Ethancao123/shark-bite/hardware/shark-bite/malenki-hv.kicad_pcb

## KiCad design hardware/shark-bite/malenki-hv.kicad_pcb (2024-10-05)

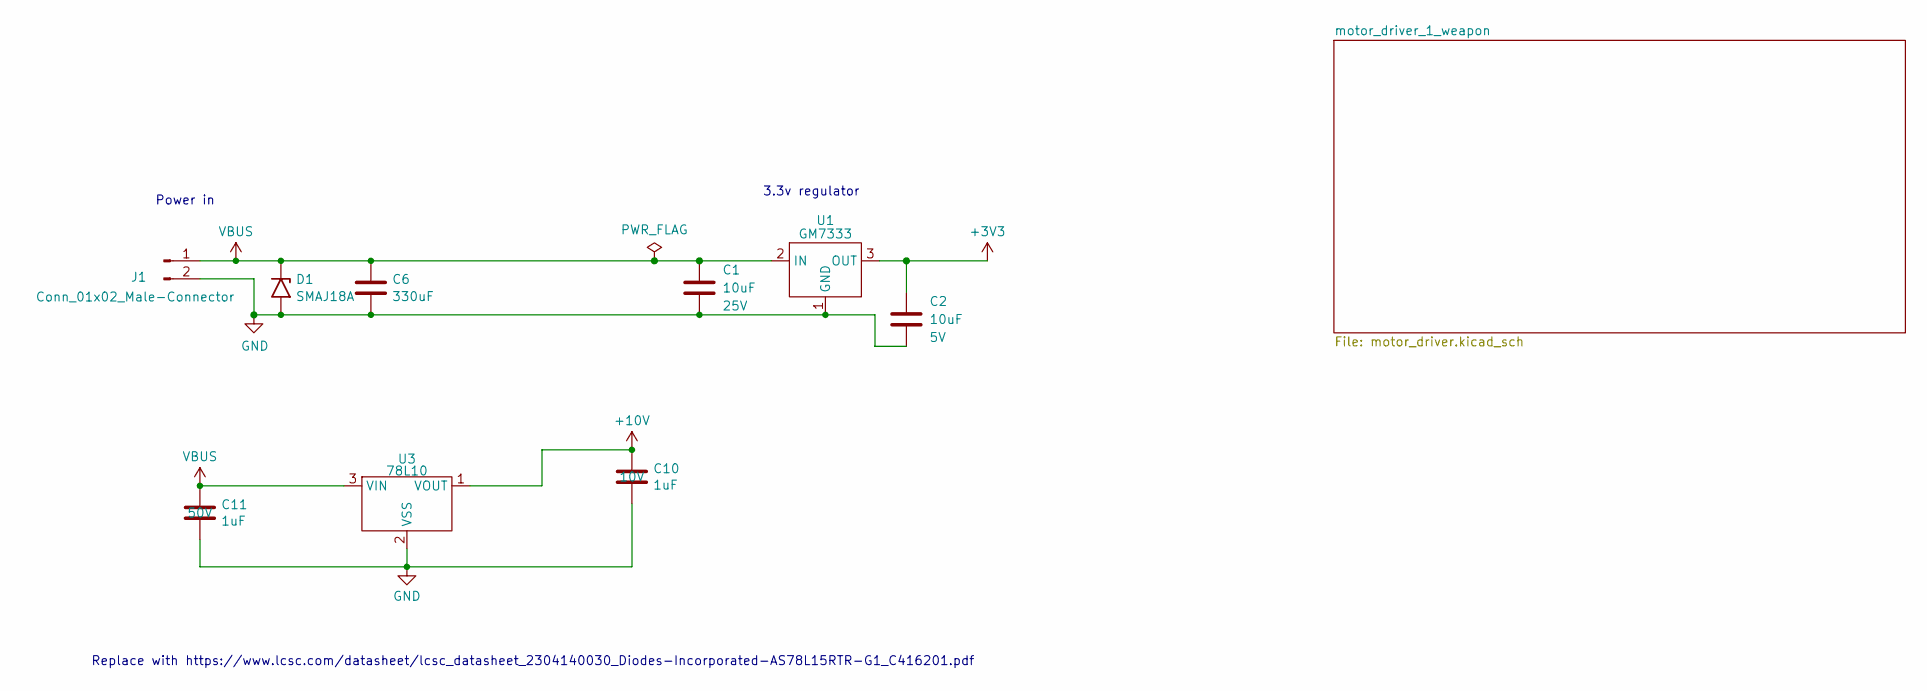
[picture p1: schematic malenki-hv.kicad_sch]

Parts:
C1, C2: 10uF; C_0603_1608Metric
C6: 330uF; C_0603_1608Metric
C10, C11: 1uF; C_0603_1608Metric
D1: SMAJ18A; D_SMA; LCSC C20883287
J1: Conn_01x02_Male-Connector; Power Input
U1: GM7333; SOT-89-3; LCSC C2833582
U3: 78L10; SOT-89-3; LCSC C6718417

Connections:
+3V3: C2.1, U1.3 (OUT); also elsewhere on the board
+10V: C10.1, U3.1 (VOUT); also elsewhere on the board
GND: C1.2, C2.2, C6.2, C10.2, C11.2, D1.2 (A2), J1.2, U1.1 (GND), U3.2 (VSS); also elsewhere on the board
VBUS: C1.1, C6.1, C11.1, D1.1 (A1), J1.1, U1.2 (IN), U3.3 (VIN); also elsewhere on the board

Notes on the sheet:
Power in
3.3v regulator
Replace with https://www.lcsc.com/datasheet/lcsc_datasheet_2304140030_Diodes-Incorporated-AS78L15RTR-G1_C416201.pdf

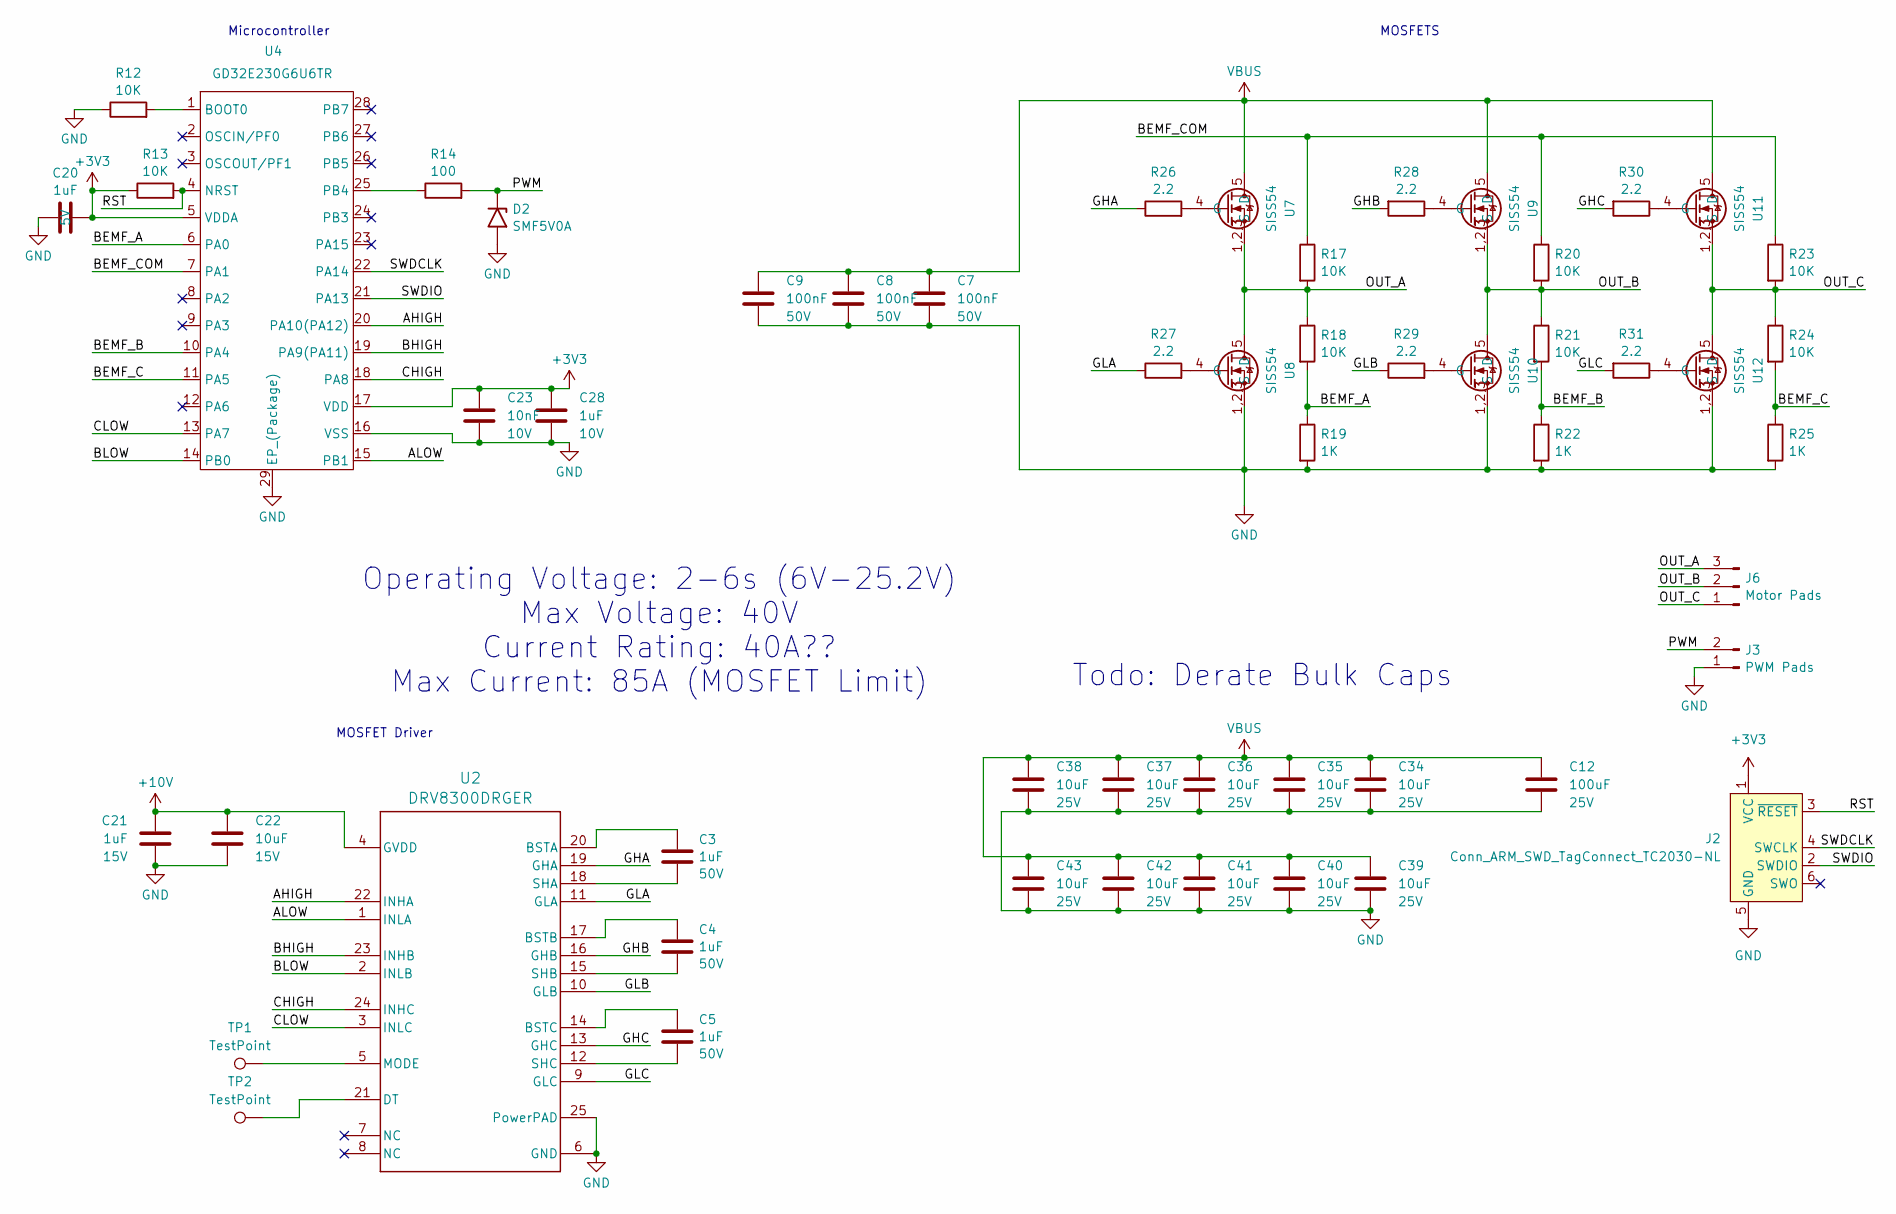
[picture p2: schematic motor_driver.kicad_sch]

Parts:
C3, C4, C5: 1uF; C_0603_1608Metric; LCSC C307331
C7, C8, C9: 100nF; C_0402_1005Metric; LCSC C307331
C12: 100uF; LCSC C556232
C20, C21, C28: 1uF; C_0402_1005Metric_Pad0.74x0.62mm_HandSolder
C22: 10uF; C_0402_1005Metric_Pad0.74x0.62mm_HandSolder
C23: 10nF; C_0402_1005Metric_Pad0.74x0.62mm_HandSolder
C34, C35, C36, C37, C38, C39, C40, C41, C42, C43: 10uF; C_0603_1608Metric
D2: SMF5V0A; D_SMF; LCSC C1972946
J2: Conn_ARM_SWD_TagConnect_TC2030-NL; Tag-Connect_TC2030-IDC-NL_2x03_P1.27mm_Vertical
J3: PWM Pads; PinHeader_1x02_P1.00mm_Vertical
J6: Motor Pads; ESC Pads
R12, R13, R17, R18, R20, R21, R23, R24: 10K; R_0402_1005Metric; LCSC C25744
R14: 100; R_0402_1005Metric
R19, R22, R25: 1K; R_0402_1005Metric; LCSC C11702
R26, R27, R28, R29, R30, R31: 2.2; R_0603_1608Metric
TP1, TP2: TestPoint; TestPoint_Pad_1.0x1.0mm
U2: DRV8300DRGER; RGE0024B-IPC_A
U4: GD32E230G6U6TR; QFN-28-1EP_4x4mm_P0.4mm_EP2.6x2.6mm; LCSC C2835081
U7, U8, U9, U10, U11, U12: SISS54; 1212-8S; LCSC C67862

Connections:
+3V3: C20.1, C23.2, C28.2, J2.1 (VCC), R13.1, U4.5 (VDDA), U4.17 (VDD); also elsewhere on the board
+10V: C21.2, C22.2, U2.4 (GVDD); also elsewhere on the board
/motor_driver_1_weapon/AHIGH: U2.22 (INHA), U4.20 (PA10(PA12))
/motor_driver_1_weapon/ALOW: U2.1 (INLA), U4.15 (PB1)
/motor_driver_1_weapon/BEMF_A: R18.2, R19.1, U4.6 (PA0)
/motor_driver_1_weapon/BEMF_B: R21.2, R22.1, U4.10 (PA4)
/motor_driver_1_weapon/BEMF_C: R24.2, R25.1, U4.11 (PA5)
/motor_driver_1_weapon/BEMF_COM: R17.1, R20.1, R23.1, U4.7 (PA1)
/motor_driver_1_weapon/BHIGH: U2.23 (INHB), U4.19 (PA9(PA11))
/motor_driver_1_weapon/BLOW: U2.2 (INLB), U4.14 (PB0)
/motor_driver_1_weapon/CHIGH: U2.24 (INHC), U4.18 (PA8)
/motor_driver_1_weapon/CLOW: U2.3 (INLC), U4.13 (PA7)
/motor_driver_1_weapon/GHA: R26.1, U2.19 (GHA)
/motor_driver_1_weapon/GHB: R28.2, U2.16 (GHB)
/motor_driver_1_weapon/GHC: R30.2, U2.13 (GHC)
/motor_driver_1_weapon/GLA: R27.1, U2.11 (GLA)
/motor_driver_1_weapon/GLB: R29.1, U2.10 (GLB)
/motor_driver_1_weapon/GLC: R31.2, U2.9 (GLC)
/motor_driver_1_weapon/OUT_A: J6.3, R17.2, R18.1, U7.1,2,3 (S), U8.5 (D)
/motor_driver_1_weapon/OUT_B: J6.2, R20.2, R21.1, U9.1,2,3 (S), U10.5 (D)
/motor_driver_1_weapon/OUT_C: J6.1, R23.2, R24.1, U11.1,2,3 (S), U12.5 (D)
/motor_driver_1_weapon/PWM: D2.1 (A1), J3.2, R14.2
/motor_driver_1_weapon/RST: J2.3 (~RESET), R13.2, U4.4 (NRST)
/motor_driver_1_weapon/SWDCLK: J2.4 (SWCLK), U4.22 (PA14)
/motor_driver_1_weapon/SWDIO: J2.2 (SWDIO), U4.21 (PA13)
GND: C7.2, C8.2, C9.2, C12.2, C20.2, C21.1, C22.1, C23.1, C28.1, C34.2, C35.2, C36.2, C37.2, C38.2, C39.2, C40.2, C41.2, C42.2, C43.2, D2.2 (A2), J2.5 (GND), J3.1, R12.1, R19.2, R22.2, R25.2, U2.6 (GND), U2.25 (PowerPAD), U4.16 (VSS), U4.29 (EP_(Package)), U8.1,2,3 (S), U10.1,2,3 (S), U12.1,2,3 (S); also elsewhere on the board
unnamed: C3.1, U2.20 (BSTA)
unnamed: C4.1, U2.17 (BSTB)
unnamed: C5.1, U2.14 (BSTC)
unnamed: TP2.1, U2.21 (DT)
unnamed: TP1.1, U2.5 (MODE)
unnamed: C3.2, U2.18 (SHA)
unnamed: C4.2, U2.15 (SHB)
unnamed: C5.2, U2.12 (SHC)
unnamed: R12.2, U4.1 (BOOT0)
unnamed: R14.1, U4.25 (PB4)
unnamed: R26.2, U7.4 (G)
unnamed: R27.2, U8.4 (G)
unnamed: R28.1, U9.4 (G)
unnamed: R29.2, U10.4 (G)
unnamed: R30.1, U11.4 (G)
unnamed: R31.1, U12.4 (G)
VBUS: C7.1, C8.1, C9.1, C12.1, C34.1, C35.1, C36.1, C37.1, C38.1, C39.1, C40.1, C41.1, C42.1, C43.1, U7.5 (D), U9.5 (D), U11.5 (D); also elsewhere on the board

Notes on the sheet:
Todo: Derate Bulk Caps
Operating Voltage: 2-6s (6V-25.2V) Max Voltage: 40V Current Rating: 40A?? Max Current: 85A (MOSFET Limit)
MOSFET Driver
MOSFETS
Microcontroller

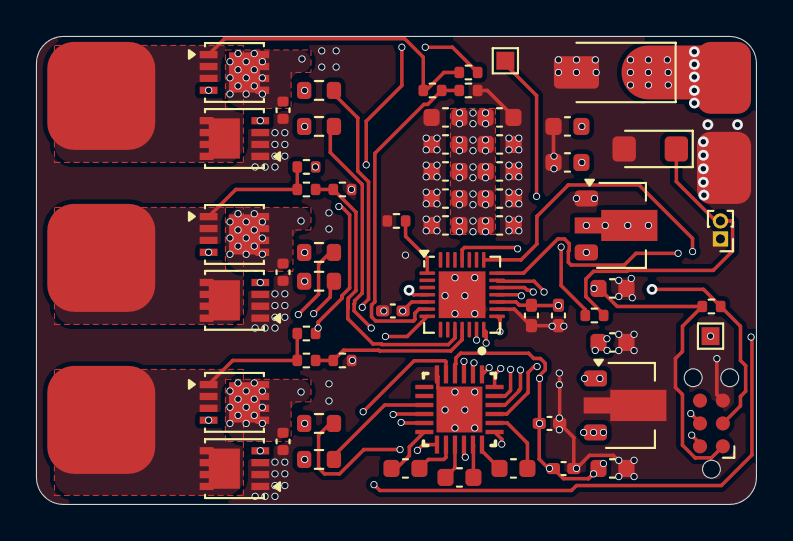
[picture p3: board malenki-hv.kicad_pcb from above]

Board: 4 copper layers, 40.0 x 26.0 mm, 62 parts (0 on the bottom side), 43 nets.
