Ethancao123/shark-bite/(commit log)

2024-04-22 Created ESC Microcontroller and MOSFET Driver
    [drv8837_breakout.kicad_pcb, drv8837_breakout.sch, malenki-1616.kicad_pcb, malenki-1616.kicad_sch, malenki-holder.FCStd, malenki-hv-bom.csv, malenki-hv.kicad_pcb, malenki-hv.kicad_sch]
2024-04-22 Added TVS Diodes
    [malenki-hv.kicad_sch, motor_driver.kicad_sch]
2024-04-22 Removed Extra Diodes
    [malenki-hv.kicad_sch, motor_driver.kicad_sch]
2024-04-27 Routed Without Debug
    [malenki-hv.kicad_pcb, motor_driver.kicad_sch]
2024-04-27 Added Gate Resistors and Power Capacitors
    [malenki-hv.kicad_pcb, motor_driver.kicad_sch]
2024-05-17 Added tag-connect
    [malenki-hv.kicad_sch, motor_driver.kicad_sch]
2024-06-13 Update PCB
    [malenki-hv.kicad_sch, motor_driver.kicad_sch]
2024-08-15 Minor Changes???
    [malenki-hv.kicad_pcb, malenki-hv.kicad_sch, motor_driver.kicad_sch]
2024-08-17 Design Finished
    [malenki-hv.kicad_pcb, malenki-hv.kicad_sch, motor_driver.kicad_sch]
2024-10-04 Update JLC Files
    [BOM-malenki-hv.csv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]
2024-10-05 Moved Intersecting Traces
    [malenki-hv.kicad_pcb]
